danindudesilva/nbiotideaboard/SIM7000_Ideaboard_Bill_of Materials.xlsx

Qty | Value | Device | Package | Parts | Description | BOM | MF | MPN | OC_FARNELL | OC_NEWARK | PROD_ID | VALUE
1 | LiPo | JST_2PIN-SMT | JST-PH-2-SMT | LIPO | JST 2-Pin Connectors of various flavors
3 | Digital, I2C, PGM | PINHD-1X6 | 1X06 | DIGITAL, I2C, PGM | PIN HEADER
1 | SPI | PINHD-1X9 | 1X09 | SPI | PIN HEADER
1 | On off | SWITCH-SPDT-SMD-A | SWITCH-SPST-SMD-A | S1 | SPDT Switch |  |  |  |  |  | SWCH-10651
4 | Push button | SWITCH_TACT_SMT4.6X2.8 | BTN_KMR2_4.6X2.8 | BTN, PWR, RESET, RST | SMT Tact Switches
1 | SMF15C | TVSARRAY_5LANE | SOT363 | D1 | Voltage Transient Suppressor Array
1 | Level shifter | TXB0108PWR | TSSOP20 | U2 | 8-Bit Bi-Directional Level Shifter
1 | SIM7000 USB | USB_MICRO_20329_V2 | 4UCONN_20329_V2 | X1 | USB Connectors
2 | 100k | R-US_M0805 | M0805 | R26, R29 | RESISTOR, American symbol
5 | 100n | C-0805 | 805 | C10, C11, C13, C14, C15 | Ceramic Capacitors
3 | 100n | C-EUC0805 | C0805 | C5, C6, C7 | CAPACITOR, European symbol
1 | 100n | CAP_CERAMIC_0805MP | _0805MP | C22 | Ceramic Capacitors
1 | 100uF | 22UF-1210-16V-20% | 1210 | C24 | 22ｵF ceramic capacitors
2 | 10k | R-EU_R0805 | R0805 | R4, R9 | RESISTOR, European symbol
1 | 10pF | 22UF-0805-6.3V-20% | 805 | C27 | 22ｵF ceramic capacitors |  |  |  |  |  | CAP-08402 | 22uF
2 | 10uF | CAP_CERAMIC_0805 | _0805 | C17, C21 | Ceramic Capacitors
2 | 10uF | CAP_CERAMIC_0805MP | _0805MP | C18, C19 | Ceramic Capacitors
1 | 16MHz | CRYSTALCTS406 | CTS406 | Q1 | CRYSTAL |  |  |  | unknown | unknown
1 | 1M | R-EU_R0805 | R0805 | R3 | RESISTOR, European symbol
5 | 1k | R-EU_R0805 | R0805 | R2, R5, R6, R7, R8 | RESISTOR, European symbol
1 | 1k | R-US_M0805 | M0805 | R25 | RESISTOR, American symbol
1 | 1uF | CAP_CERAMIC_0805MP | _0805MP | C20 | Ceramic Capacitors
1 | 2.2UH3A | INDUCTOR-IFSC1515AHER2R2M01 | INDUCTOR_4X4MM | L3 | Inductors |  |  |  |  |  | NDUC-13770 | 2.2UH3A
1 | 2.2k | R-US_M0805 | M0805 | R27 | RESISTOR, American symbol
4 | 22R | R-0805 | 805 | R1, R10, R11, R13
3 | 22pF | C-0805 | 805 | C8, C9, C12 | Ceramic Capacitors
3 | 22pF | C-EUC0805 | C0805 | C1, C3, C4 | CAPACITOR, European symbol
2 | 22uF | 22UF-0805-6.3V-20% | 805 | C23, C26 | 22ｵF ceramic capacitors |  |  |  |  |  | CAP-08402 | 22uF
2 | 300R | R-0805 | 805 | R21, R22
1 | 33nH | L0805 | L0805 | L4 | Inductor |  |  | RK73B2ATTDD104J
1 | 33pF | 22UF-0805-6.3V-20% | 805 | C25 | 22ｵF ceramic capacitors |  |  |  |  |  | CAP-08402 | 22uF
1 | 33pF | C-0805 | 805 | C16 | Ceramic Capacitors
4 | 4.7k | R-0805 | 805 | R15, R17, R18, R23
6 | 47k | R-0805 | 805 | R12, R14, R16, R19, R20, R24
1 | 500mA | L-EUL1812 | L1812 | L2 | INDUCTOR, European symbol
2 | 750k | R-US_M0805 | M0805 | R28, R30 | RESISTOR, American symbol
4 | s9013 | TRANSISTOR-NPN-SOT23 | SOT23 | Q2, Q3, Q4, Q5 | NPN audion
1 | AP2112-3.3 | VREG_SOT23-5 | SOT23-5 | U5 | SOT23-5 Fixed Voltage Regulators
1 | ATMEGA328P-20MU | MEGA8-AI | TQFP32-08 | IC1 | MICROCONTROLLER
1 | BLM21 | WE-CBF_0805 | 805 | L1 | SMD EMI Suppression Ferrite Beads
1 | GREEN | LED'0805' | LED-0805 | D2
1 | GREEN | LEDCHIP-LED0805 | CHIP-LED0805 | LED4 | LED
1 | MCP73831T-2ACI/OT | MCP73831/2 | SOT23-5 | U4 | MCP73831/2 LIPO Charger
1 | MICROSIM | MICROSIM | MICROSIM | U1
1 | MMSZ5231BT1G | DIODE-ZENERSOD123 | SOD-123 | D5 | Zener Diode
4 | MOUNTINGHOLE3.0THIN | MOUNTINGHOLE3.0THIN | MOUNTINGHOLE_3.0_PLATEDTHIN | $H1, $H2, $H3, $H4 | Mounting Hole | EXCLUDE
1 | ORANGE | LED0805 | CHIPLED_0805 | D4 | LED
1 | PAM2401 | PAM2401 | MSOP8 | U6 | PAM2401 - Boost PMIC |  |  |  |  |  | IC-13769 | PAM2401
1 | RED | LED'0805' | LED-0805 | D3
1 | SIM7000 | SIM7000 | SIM7000 | U3
2 | SPARKFUN-PASSIVES_JUMPER-PTH-2-NC | SPARKFUN-PASSIVES_JUMPER-PTH-2-NC | SPARKFUN-PASSIVES_PTH-JUMPER-NC_BOTTOM_NO_SILK | SJ1, SJ2
2 | U-FL | ANTENNA-U-FL | 4P-U-FL | GPS, RF
1 | YELLOW | LEDCHIP-LED0805 | CHIP-LED0805 | LED3 | LED
