danindudesilva/nbiotideaboard/Final-Schematic.pdf

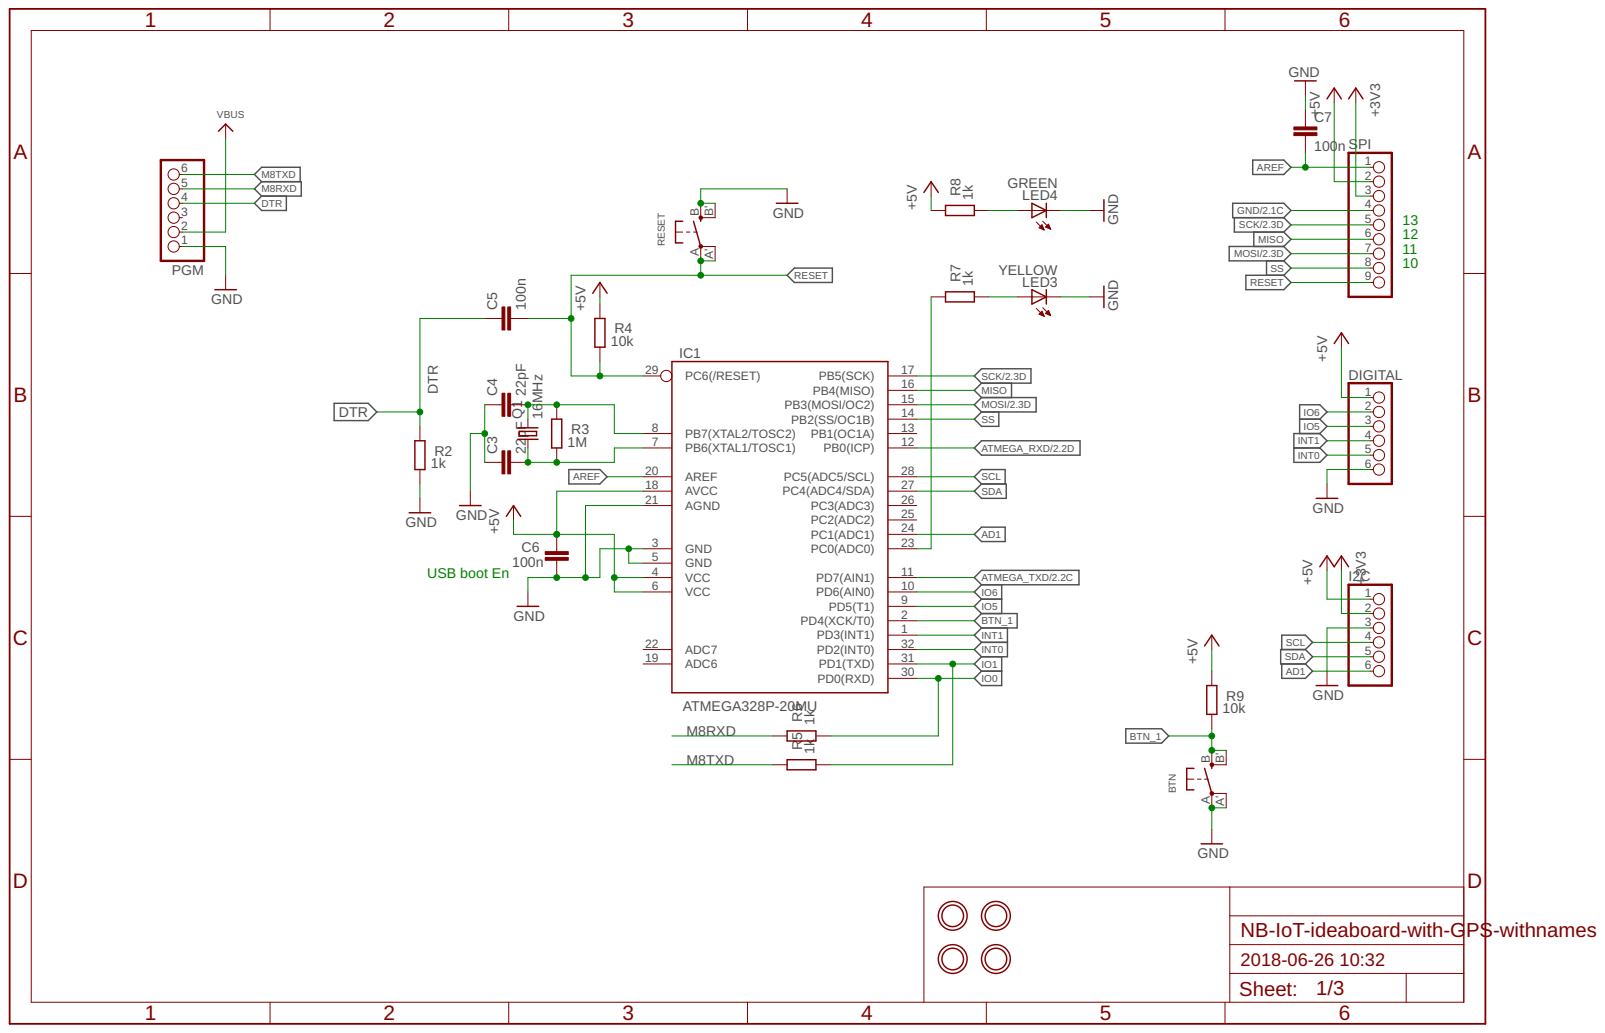
[picture p1: page 1]

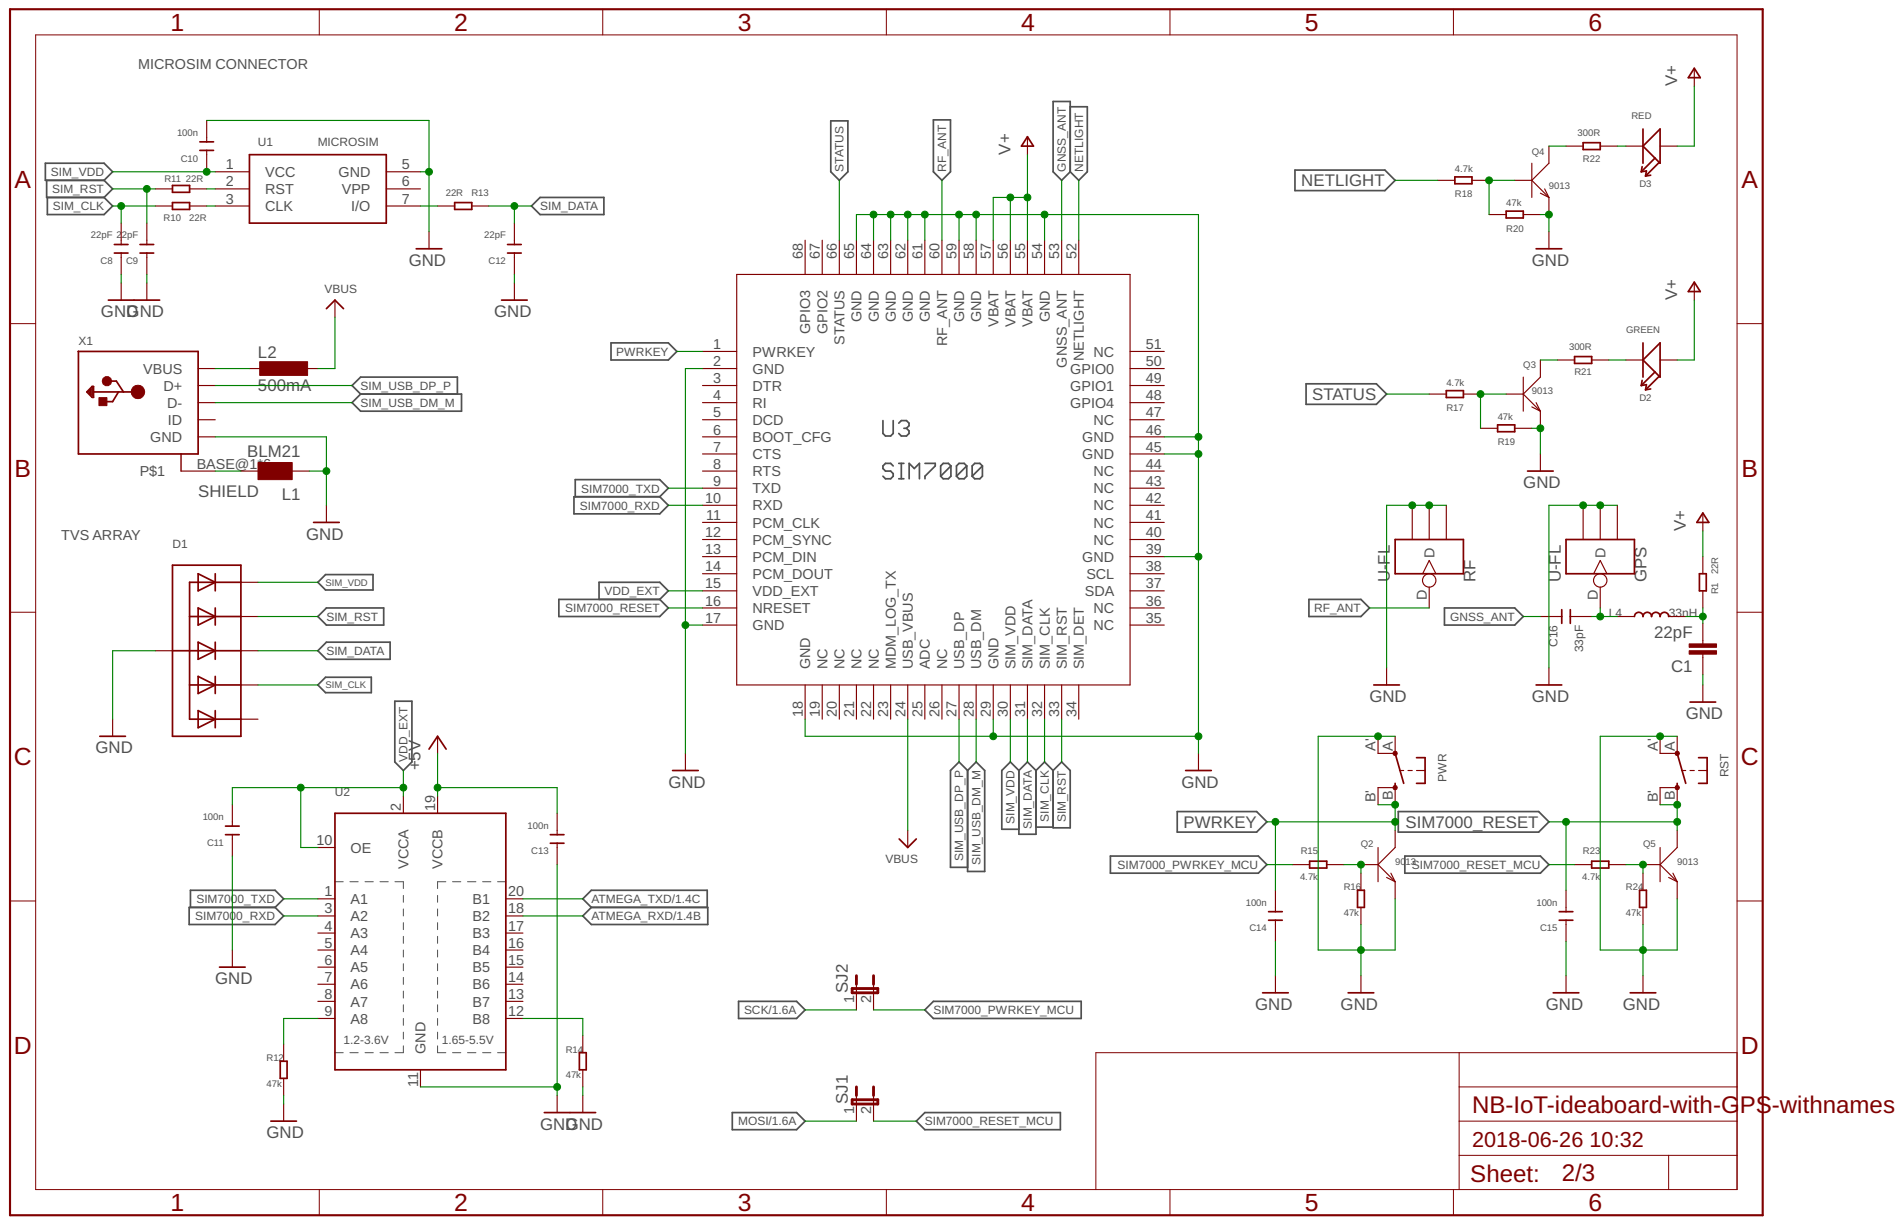
[picture p2: page 2]

MICROSIM CONNECTOR

NB-IoT-ideaboard-with-GPS-withnames

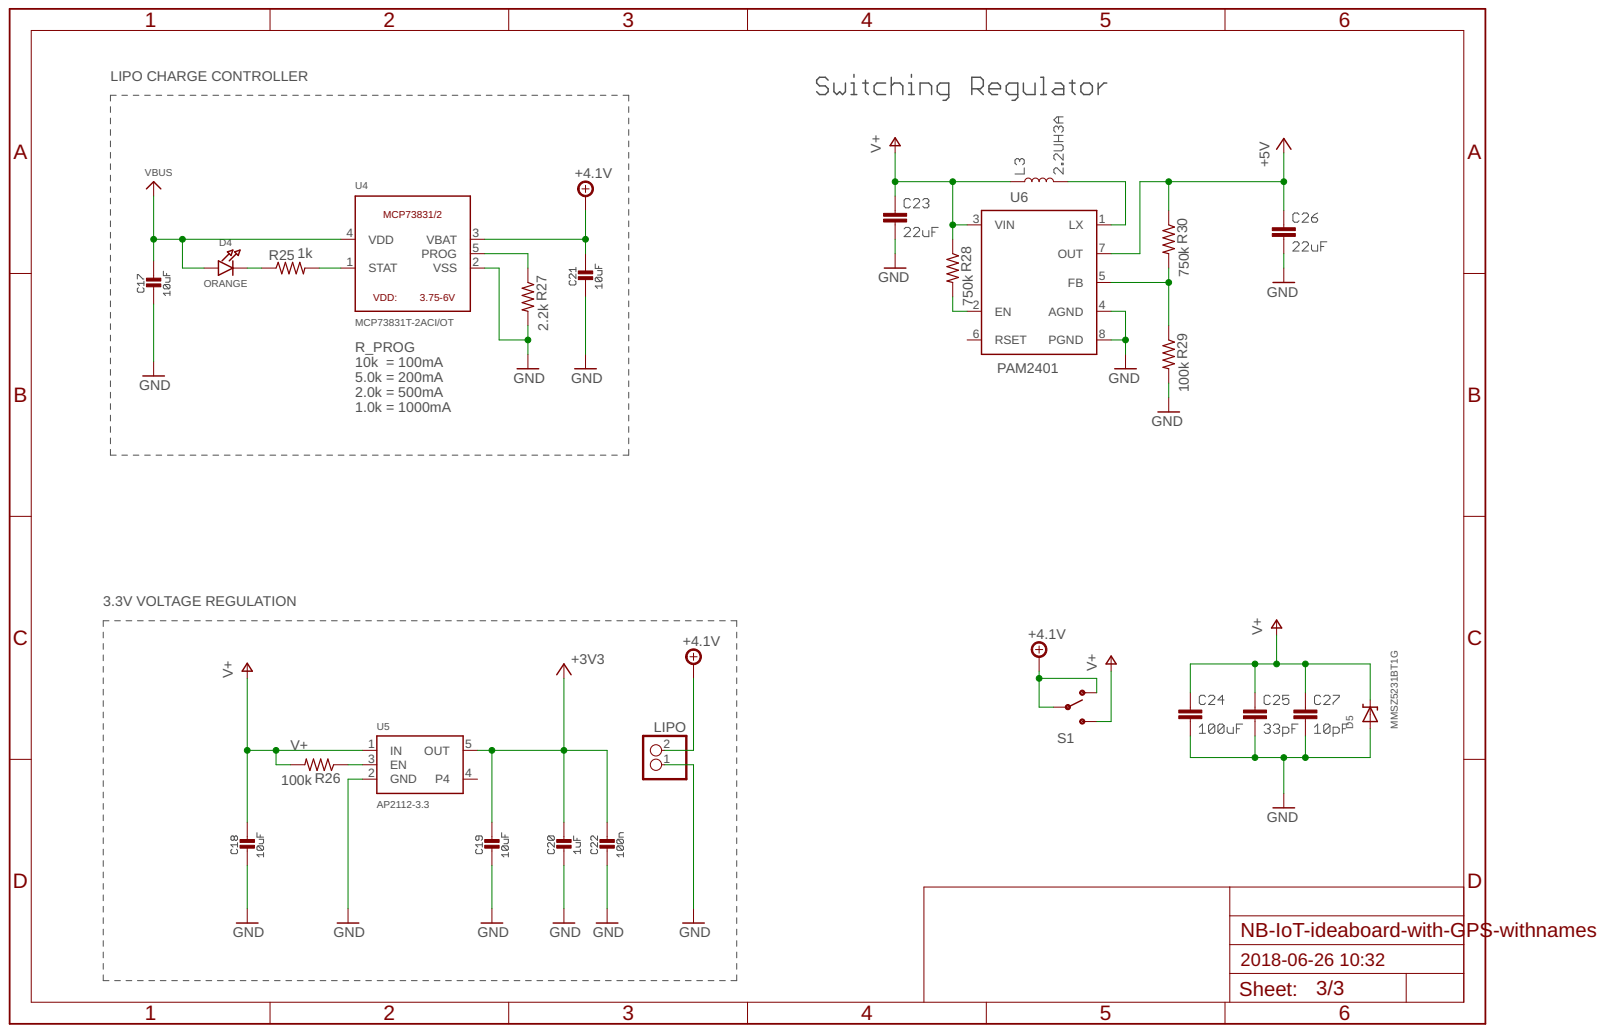
[picture p3: page 3]

NB-IoT-ideaboard-with-GPS-withnames
