danindudesilva/nbiotideaboard/SolderBottom.pdf

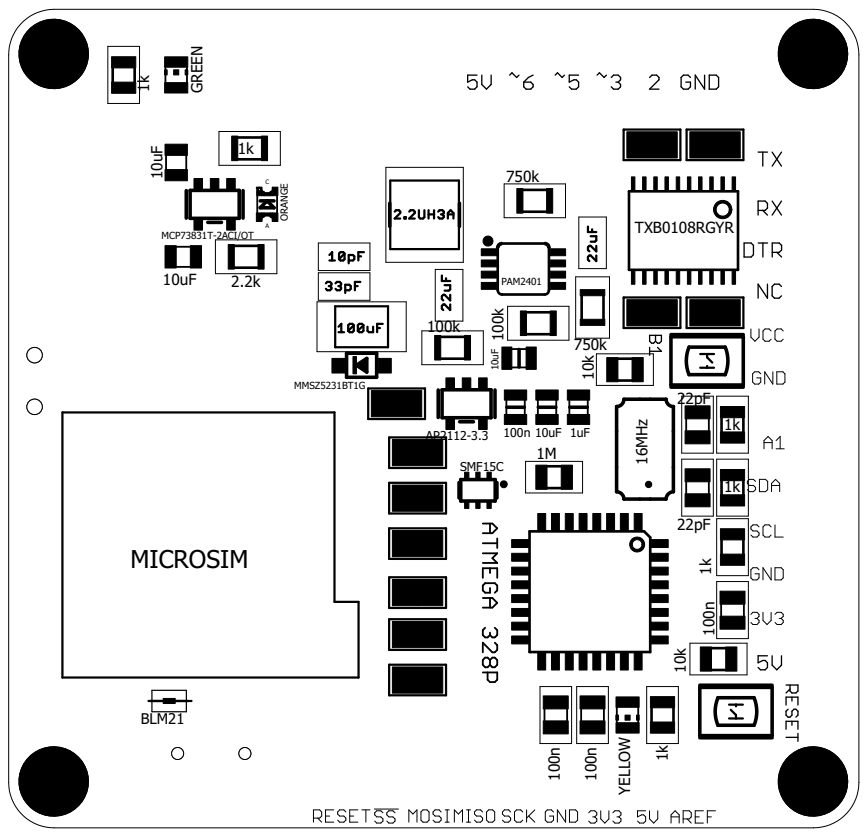
[picture p4: page 1]
