danindudesilva/nbiotideaboard/SolderTop.pdf

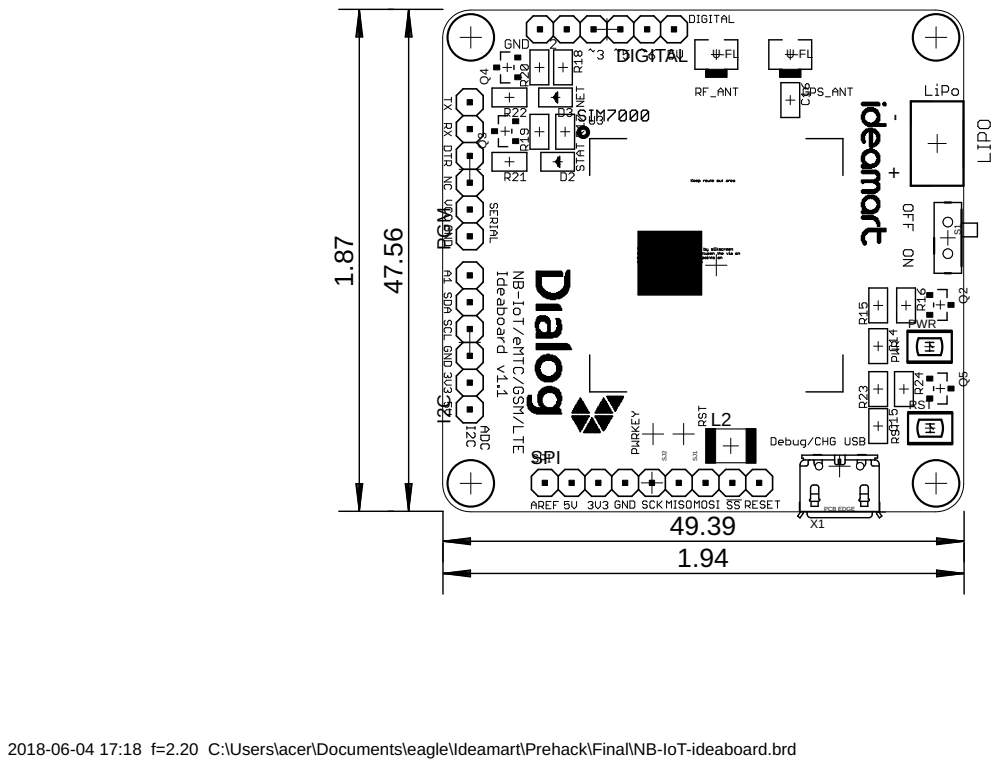
[picture p5: page 1]

2018-06-04 17:18 f=2.20 C:\Users\acer\Documents\eagle\Ideamart\Prehack\Final\NB-IoT-ideaboard.brd
