danindudesilva/nbiotideaboard/NB-IoT-ideaboard-with-GPS-withnames.brd

## EAGLE design NB-IoT-ideaboard-with-GPS-withnames.brd (2020-05-01)

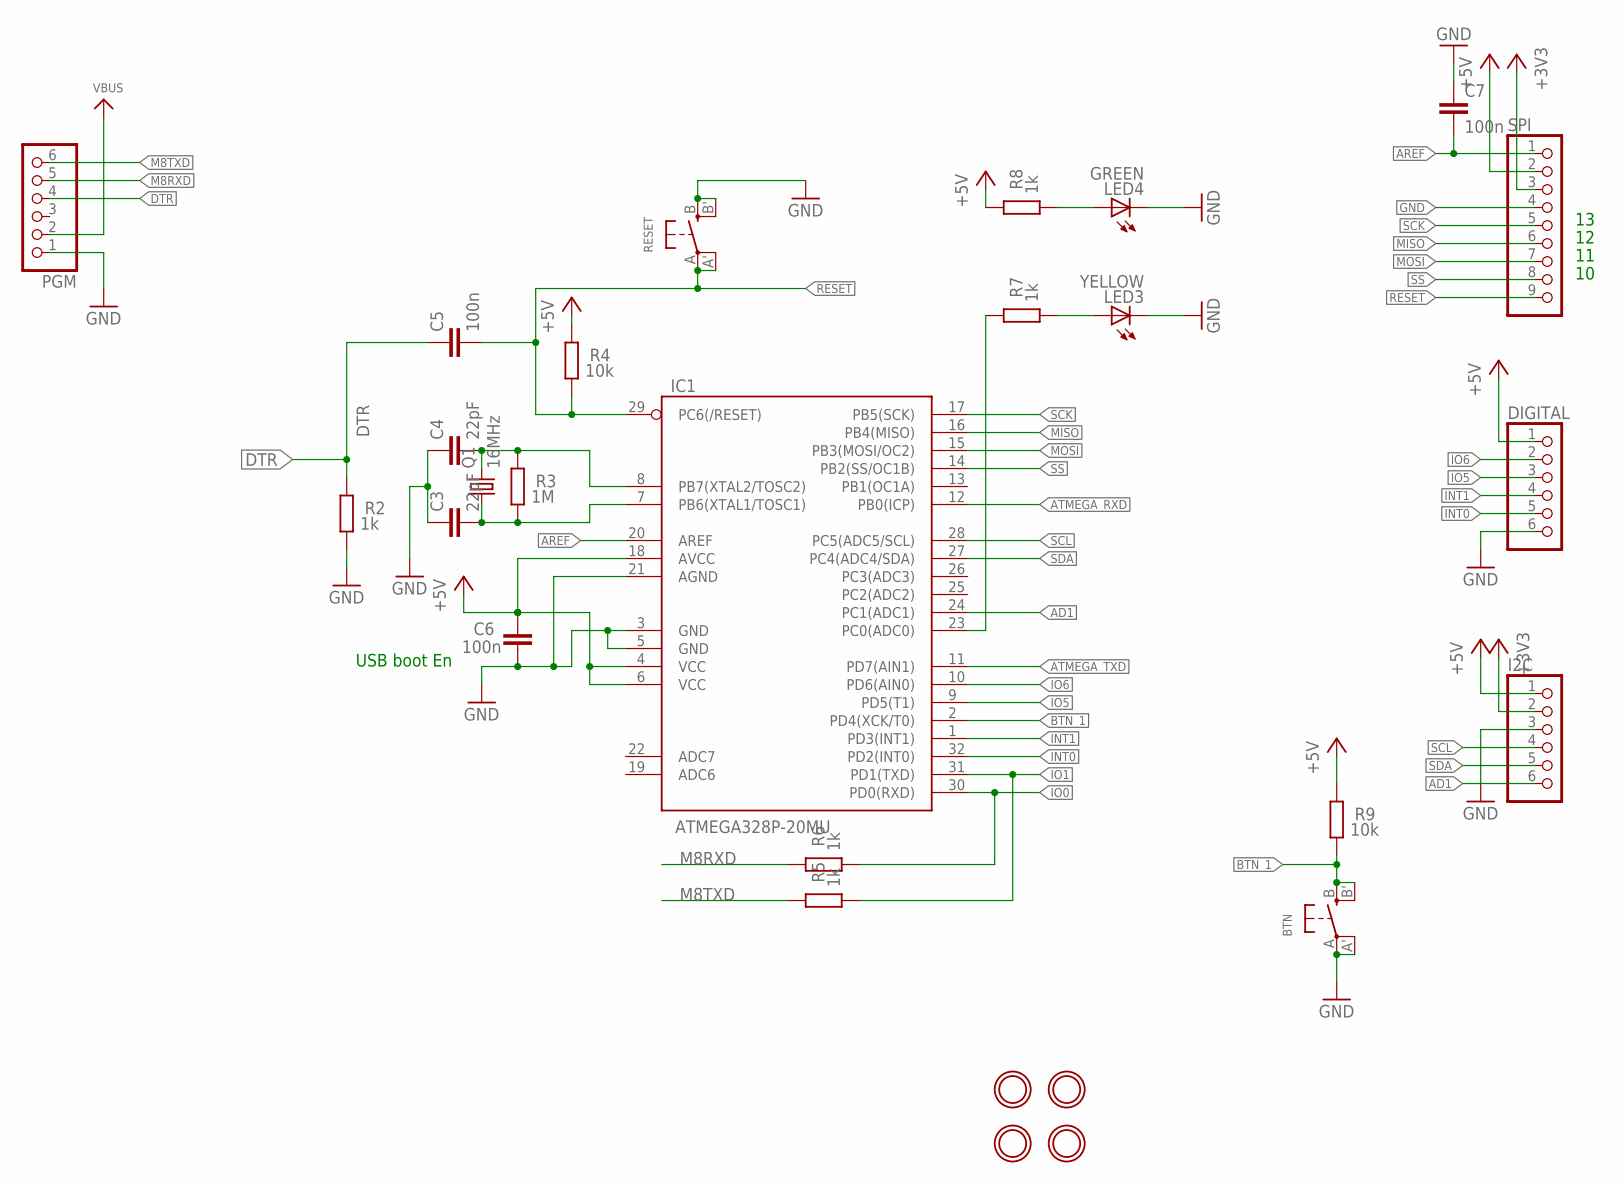
[picture p6: schematic NB-IoT-ideaboard-with-GPS-withnames.sch, sheet 1]

Parts:
$H1, $H2, $H3, $H4: MOUNTINGHOLE3.0THIN; MOUNTINGHOLE_3.0_PLATEDTHIN
BTN: SWITCH_TACT_SMT4.6X2.8; BTN_KMR2_4.6X2.8
C3, C4: 22pF; C0805
C5, C6, C7: 100n; C0805
DIGITAL: PINHD-1X6; 1X06
I2C: PINHD-1X6; 1X06
IC1: ATMEGA328P-20MU; TQFP32-08
LED3: YELLOW; CHIP-LED0805
LED4: GREEN; CHIP-LED0805
PGM: PINHD-1X6; 1X06
Q1: 16MHz; CTS406
R2, R5, R6, R7, R8: 1k; R0805
R3: 1M; R0805
R4, R9: 10k; R0805
RESET: SWITCH_TACT_SMT4.6X2.8; BTN_KMR2_4.6X2.8
SPI: PINHD-1X9; 1X09

Connections:
+3V3: I2C.2, SPI.3; also elsewhere on the board
+5V: C6.2, DIGITAL.1, I2C.1, IC1.4 (VCC), IC1.6 (VCC), IC1.18 (AVCC), R4.2, R8.2, R9.2, SPI.2; also elsewhere on the board
AD1: I2C.6, IC1.24 (PC1(ADC1))
AREF: C7.2, IC1.20 (AREF), SPI.1
ATMEGA_RXD: IC1.12 (PB0(ICP)); also elsewhere on the board
ATMEGA_TXD: IC1.11 (PD7(AIN1)); also elsewhere on the board
BTN_1: BTN.B (S), BTN.B' (S1), IC1.2 (PD4(XCK/T0)), R9.1
DTR: C5.1, PGM.4, R2.2
GND: BTN.A, BTN.A' (P1), C3.1, C4.1, C6.1, C7.1, DIGITAL.6, I2C.3, IC1.3 (GND), IC1.5 (GND), IC1.21 (AGND), LED3.C, LED4.C, PGM.1, R2.1, RESET.B (S), RESET.B' (S1), SPI.4; also elsewhere on the board
INT0: DIGITAL.5, IC1.32 (PD2(INT0))
INT1: DIGITAL.4, IC1.1 (PD3(INT1))
IO0: IC1.30 (PD0(RXD)), R6.1
IO1: IC1.31 (PD1(TXD)), R5.1
IO5: DIGITAL.3, IC1.9 (PD5(T1))
IO6: DIGITAL.2, IC1.10 (PD6(AIN0))
M8RXD: PGM.5, R6.2
M8TXD: PGM.6, R5.2
MISO: IC1.16 (PB4(MISO)), SPI.6
MOSI: IC1.15 (PB3(MOSI/OC2)), SPI.7; also elsewhere on the board
unnamed: LED3.A, R7.1
unnamed: LED4.A, R8.1
unnamed: IC1.23 (PC0(ADC0)), R7.2
RESET: C5.2, IC1.29 (PC6(/RESET)), R4.1, RESET.A, RESET.A' (P1), SPI.9
SCK: IC1.17 (PB5(SCK)), SPI.5; also elsewhere on the board
SCL: I2C.4, IC1.28 (PC5(ADC5/SCL))
SDA: I2C.5, IC1.27 (PC4(ADC4/SDA))
SS: IC1.14 (PB2(SS/OC1B)), SPI.8
VBUS: PGM.2; also elsewhere on the board
XTAL1: C3.2, IC1.7 (PB6(XTAL1/TOSC1)), Q1.1, R3.1
XTAL2: C4.2, IC1.8 (PB7(XTAL2/TOSC2)), Q1.3 (2), R3.2

Notes on the sheet:
USB boot En

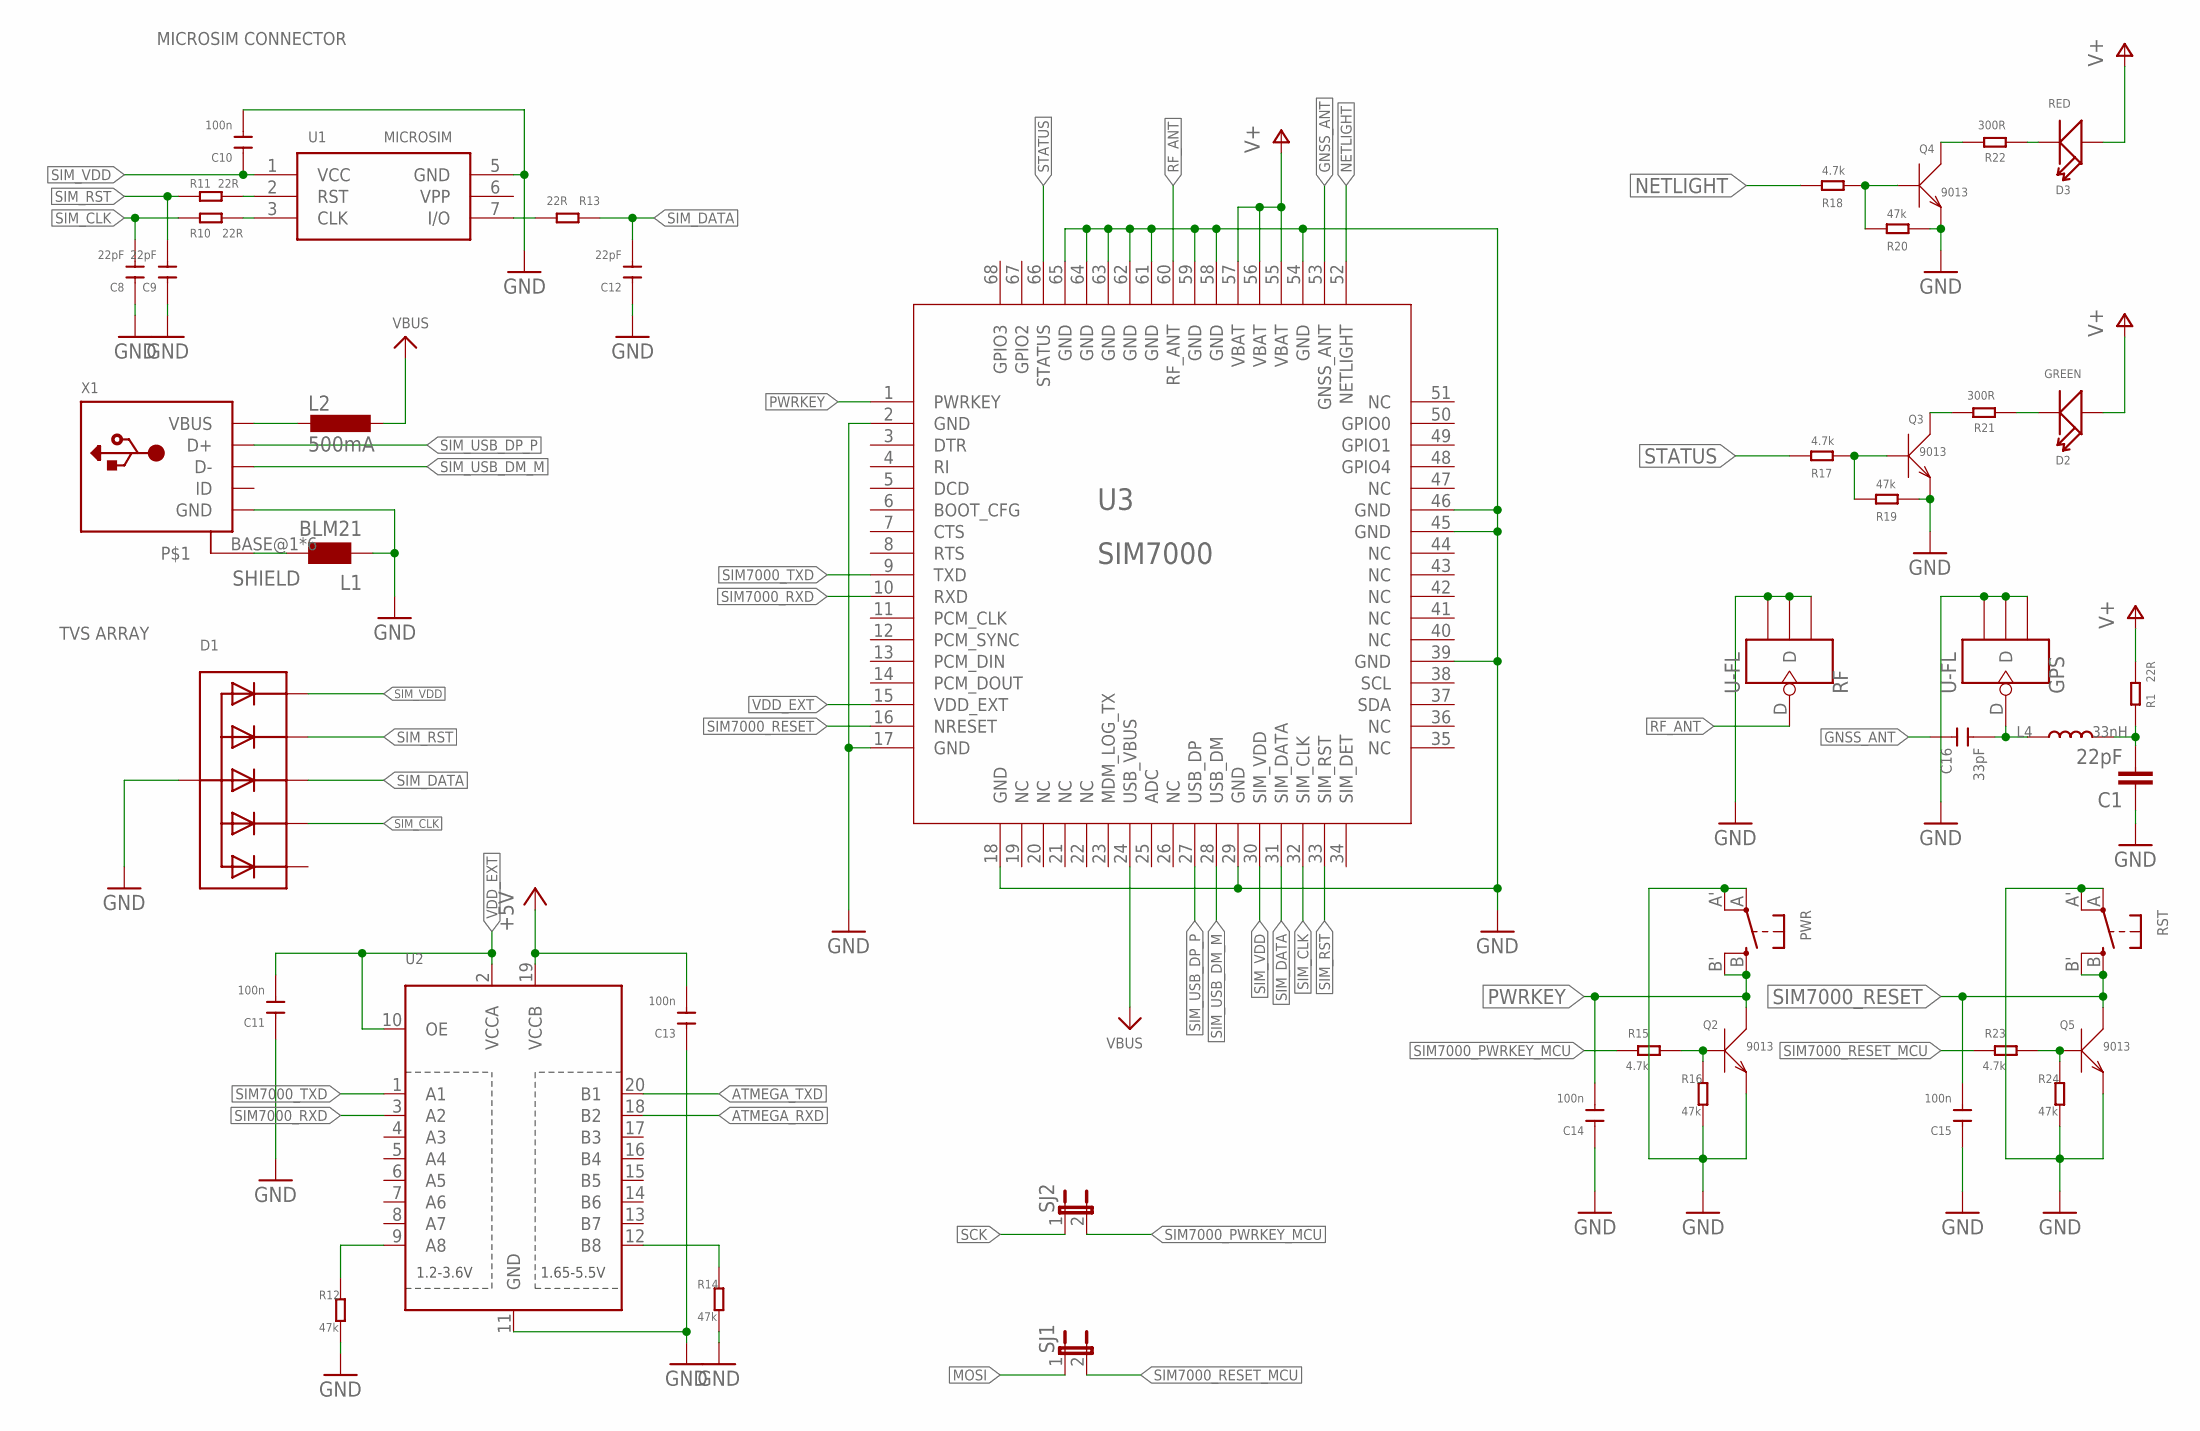
[picture p7: schematic NB-IoT-ideaboard-with-GPS-withnames.sch, sheet 2]

Parts:
C1: 22pF; C0805
C8, C9, C12: 22pF; 0805
C10, C11, C13, C14, C15: 100n; 0805
C16: 33pF; 0805
D1: TVSARRAY_5LANE; SOT363
D2: GREEN; LED-0805
D3: RED; LED-0805
GPS: U-FL; 4P-U-FL
L1: BLM21; 0805
L2: 500mA; L1812
L4: 33nH; L0805
PWR: SWITCH_TACT_SMT4.6X2.8; BTN_KMR2_4.6X2.8
Q2, Q3, Q4, Q5: 9013; SOT23
R1, R10, R11, R13: 22R; 0805
R12, R14, R16, R19, R20, R24: 47k; 0805
R15, R17, R18, R23: 4.7k; 0805
R21, R22: 300R; 0805
RF: U-FL; 4P-U-FL
RST: SWITCH_TACT_SMT4.6X2.8; BTN_KMR2_4.6X2.8
SJ1, SJ2: SPARKFUN-PASSIVES_JUMPER-PTH-2-NC; SPARKFUN-PASSIVES_PTH-JUMPER-NC_BOTTOM_NO_SILK
U1: MICROSIM
U2: TXB0108PWR; TSSOP20
U3: SIM7000
X1: USB_MICRO_20329_V2; 4UCONN_20329_V2

Connections:
+5V: C13.2, U2.19 (VCCB); also elsewhere on the board
ATMEGA_RXD: U2.18 (B2); also elsewhere on the board
ATMEGA_TXD: U2.20 (B1); also elsewhere on the board
GND: C1.1, C8.1, C9.1, C10.2, C11.1, C12.1, C13.1, C14.1, C15.1, D1.2 (A), GPS.GND1, GPS.GND2, GPS.GND3, L1.1, PWR.A, PWR.A' (P1), Q2.2 (E), Q3.2 (E), Q4.2 (E), Q5.2 (E), R12.2, R14.2, R16.2, R19.2, R20.2, R24.2, RF.GND1, RF.GND2, RF.GND3, RST.A, RST.A' (P1), U1.5 (GND), U2.11 (GND), U3.2 (GND), U3.17 (GND), U3.18 (GND), U3.29 (GND), U3.39 (GND), U3.45 (GND), U3.46 (GND), U3.54 (GND), U3.58 (GND), U3.59 (GND), U3.61 (GND), U3.62 (GND), U3.63 (GND), U3.64 (GND), U3.65 (GND), X1.GND; also elsewhere on the board
GNSS_ANT: C16.2, U3.53 (GNSS_ANT)
GPIO2: U3.67 (GPIO2)
GPIO3: U3.68 (GPIO3)
MOSI: SJ1.1; also elsewhere on the board
unnamed: Q3.3 (C), R21.2
unnamed: D2.-, R21.1
unnamed: Q3.1 (B), R17.2, R19.1
unnamed: R13.2, U1.7 (I/O)
unnamed: R10.1, U1.3 (CLK)
unnamed: R11.1, U1.2 (RST)
unnamed: Q5.1 (B), R23.2, R24.1
unnamed: L2.2, X1.VBUS
unnamed: Q4.3 (C), R22.2
unnamed: D3.-, R22.1
unnamed: Q4.1 (B), R18.2, R20.1
unnamed: C16.1, GPS.D, L4.1
unnamed: R12.1, U2.9 (A8)
unnamed: R14.1, U2.12 (B8)
unnamed: C1.2, L4.2, R1.2
unnamed: Q2.1 (B), R15.2, R16.1
NETLIGHT: R18.1, U3.52 (NETLIGHT)
PWRKEY: C14.2, PWR.B (S), PWR.B' (S1), Q2.3 (C), U3.1 (PWRKEY)
RF_ANT: RF.D, U3.60 (RF_ANT)
SCK: SJ2.1; also elsewhere on the board
SHIELD: L1.2, X1.BASE@1, X1.BASE@2, X1.SPRT@1, X1.SPRT@2, X1.SPRT@3, X1.SPRT@4
SIM7000_PWRKEY_MCU: R15.1, SJ2.2
SIM7000_RESET: C15.2, Q5.3 (C), RST.B (S), RST.B' (S1), U3.16 (NRESET)
SIM7000_RESET_MCU: R23.1, SJ1.2
SIM7000_RXD: U2.3 (A2), U3.10 (RXD)
SIM7000_TXD: U2.1 (A1), U3.9 (TXD)
SIM_CLK: C8.2, D1.5 (C4), R10.2, U3.32 (SIM_CLK)
SIM_DATA: C12.2, D1.4 (C3), R13.1, U3.31 (SIM_DATA)
SIM_RST: C9.2, D1.3 (C2), R11.2, U3.33 (SIM_RST)
SIM_USB_DM_M: U3.28 (USB_DM), X1.D-
SIM_USB_DP_P: U3.27 (USB_DP), X1.D+
SIM_VDD: C10.1, D1.1 (C1), U1.1 (VCC), U3.30 (SIM_VDD)
STATUS: R17.1, U3.66 (STATUS)
V+: D2.+, D3.+, R1.1, U3.55 (VBAT), U3.56 (VBAT), U3.57 (VBAT); also elsewhere on the board
VBUS: L2.1, U3.24 (USB_VBUS); also elsewhere on the board
VDD_EXT: C11.2, U2.2 (VCCA), U2.10 (OE), U3.15 (VDD_EXT)

Notes on the sheet:
TVS ARRAY
MICROSIM CONNECTOR

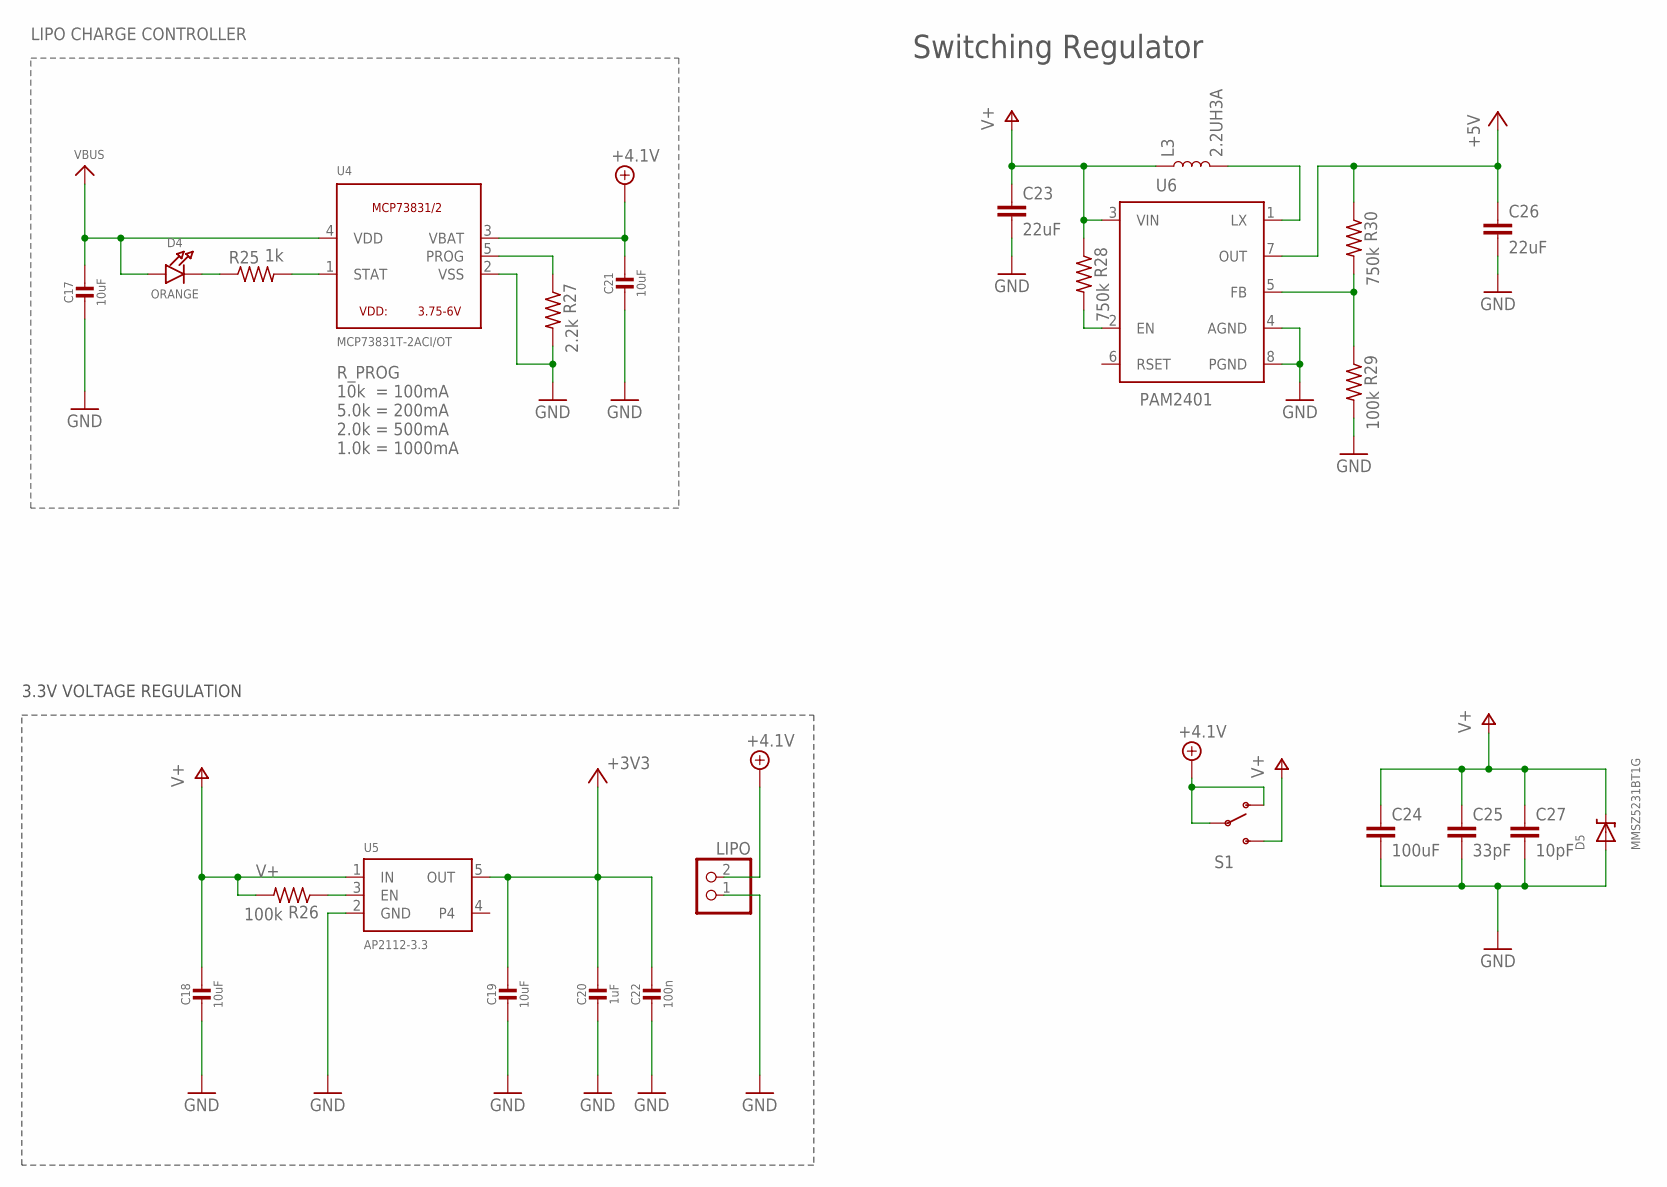
[picture p8: schematic NB-IoT-ideaboard-with-GPS-withnames.sch, sheet 3]

Parts:
C17, C21: 10uF; _0805
C18, C19: 10uF; _0805MP
C20: 1uF; _0805MP
C22: 100n; _0805MP
C23, C26: 22uF; 0805
C24: 100uF; 1210
C25: 33pF; 0805
C27: 10pF; 0805
D4: ORANGE; CHIPLED_0805
D5: MMSZ5231BT1G; SOD-123
L3: 2.2UH3A; INDUCTOR_4X4MM
LIPO: JST_2PIN-SMT; JST-PH-2-SMT
R25: 1k; M0805
R26, R29: 100k; M0805
R27: 2.2k; M0805
R28, R30: 750k; M0805
S1: SWITCH-SPDT-SMD-A; SWITCH-SPST-SMD-A
U4: MCP73831T-2ACI/OT; SOT23-5
U5: AP2112-3.3; SOT23-5
U6: PAM2401; MSOP8

Connections:
+3V3: C19.1, C20.1, C22.1, U5.5 (OUT); also elsewhere on the board
+4.1V: C21.1, LIPO.2 (1), S1.1 (O), S1.2, U4.3 (VBAT)
+5V: C26.1, R30.1, U6.7 (OUT); also elsewhere on the board
EN: R28.2, U6.2 (EN)
GND: C17.2, C18.2, C19.2, C20.2, C21.2, C22.2, C23.2, C24.2, C25.2, C26.2, C27.2, D5.A, LIPO.1 (2), R27.2, R29.2, U4.2 (VSS), U5.2 (GND), U6.4 (AGND), U6.8 (PGND); also elsewhere on the board
unnamed: R26.1, U5.3 (EN)
unnamed: D4.C, R25.1
unnamed: R25.2, U4.1 (STAT)
unnamed: R27.1, U4.5 (PROG)
unnamed: R29.1, R30.2, U6.5 (FB)
unnamed: L3.P$2 (2), U6.1 (LX)
V+: C18.1, C23.1, C24.1, C25.1, C27.1, D5.C, L3.P$1 (1), R26.2, R28.1, S1.3 (S), U5.1 (IN), U6.3 (VIN); also elsewhere on the board
VBUS: C17.1, D4.A, U4.4 (VDD); also elsewhere on the board

Notes on the sheet:
3.3V VOLTAGE REGULATION
R_PROG 10k = 100mA 5.0k = 200mA 2.0k = 500mA 1.0k = 1000mA
LIPO CHARGE CONTROLLER
Switching Regulator

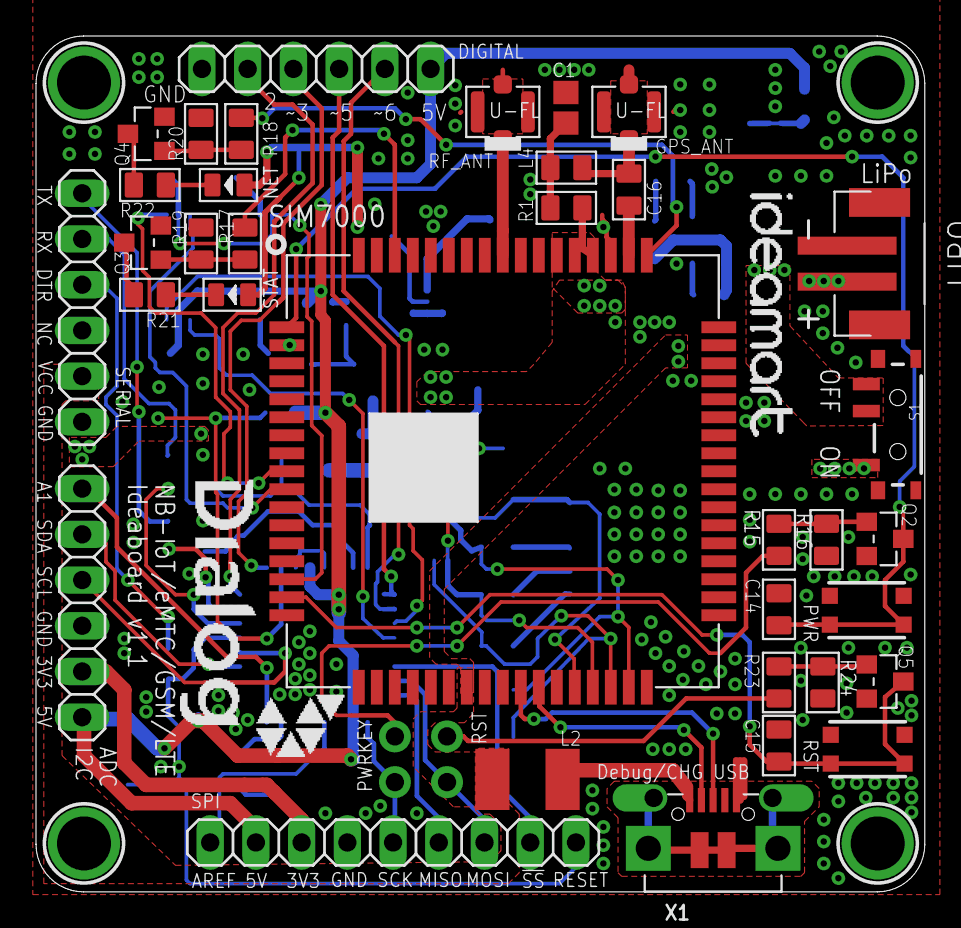
[picture p9: board NB-IoT-ideaboard-with-GPS-withnames.brd from above]

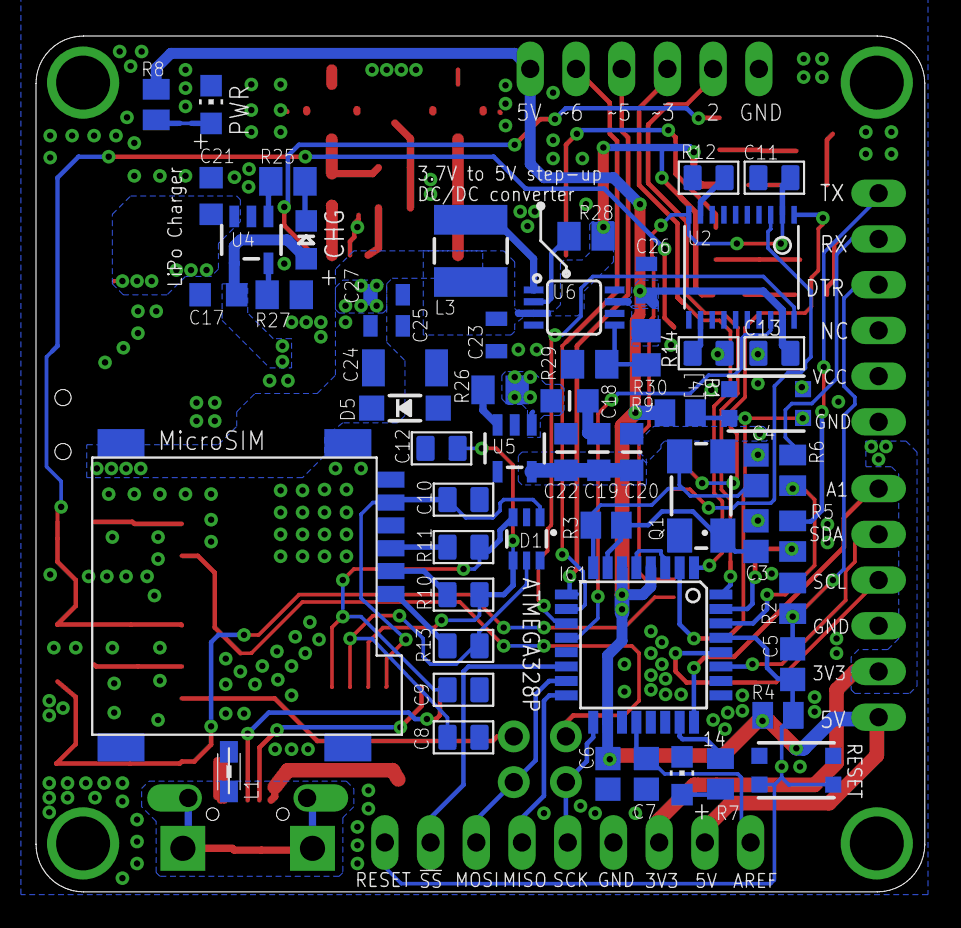
[picture p10: board NB-IoT-ideaboard-with-GPS-withnames.brd from below]

Board: 2 copper layers, 49.4 x 47.5 mm, 98 parts (57 on the bottom side), 73 nets.
